anhldbk/remote-device/Bao cao/Bia.pdf

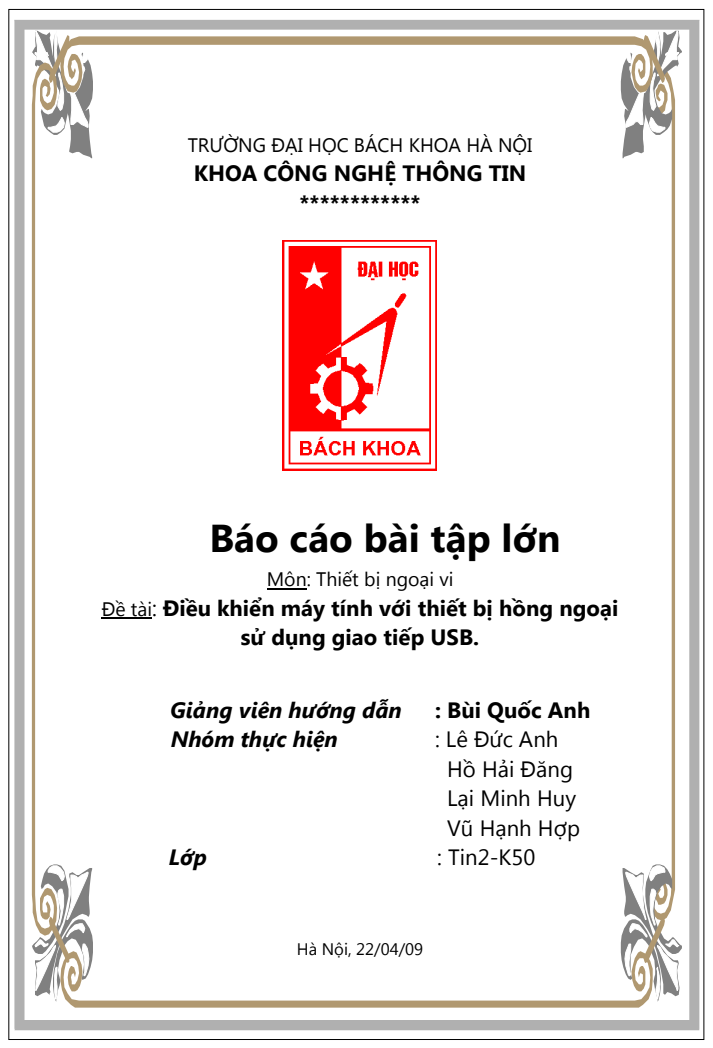
[picture p38: page 1]
Giảng viên hướng dẫn; : Bùi Quốc Anh; Nhóm thực hiện; : Lê Đức Anh; Lớp; : Tin2-K50; Hà Nội, 22/04/09

TRƯỜNG ĐẠI HỌC BÁCH KHOA HÀ NỘI
KHOA CÔNG NGHỆ THÔNG TIN

Báo cáo bài tập lớn

Môn: Thiết bị ngoại vi

Đề tài: Điều khiển máy tính với thiết bị hồng ngoại

sử dụng giao tiếp USB.

Hồ Hải Đăng
Lại Minh Huy
Vũ Hạnh Hợp
