anhldbk/remote-device/(list of files, drawings)

Other design files:
Design Proteus/RemotePC controller Circuit.DSN
